bitaxeorg/bitaxeMax/bitaxeMax.kicad_pcb

## KiCad design bitaxeMax.kicad_pcb (2025-03-11)

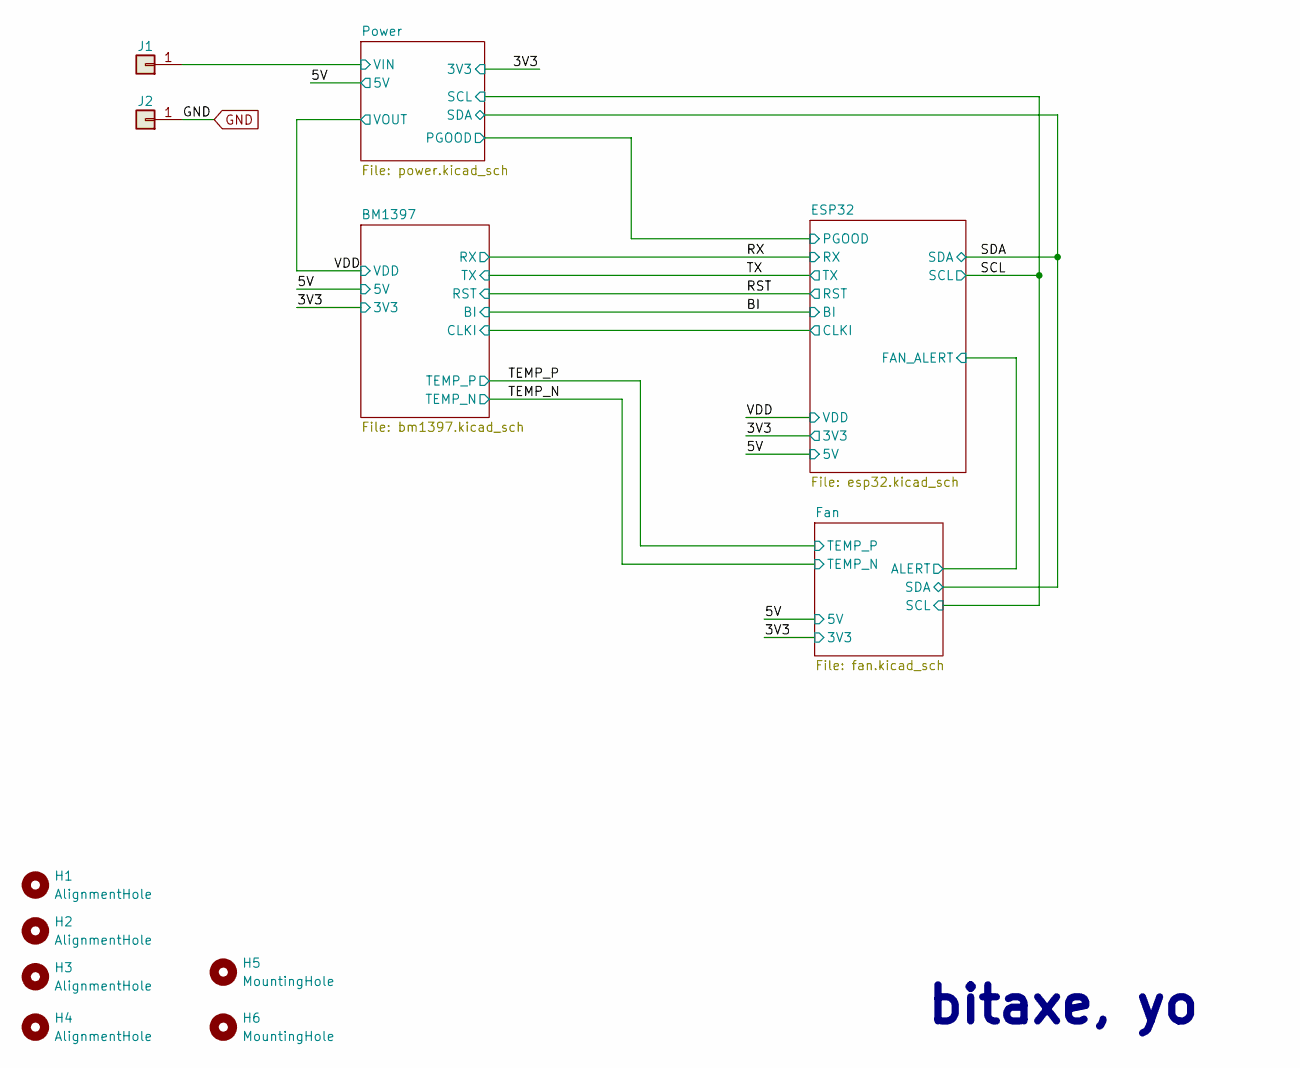
[picture p1: schematic bitaxeMax.kicad_sch, le bitaxeMax]

Parts:
H1, H2, H3, H4: AlignmentHole; MountingHole_2.2mm_M2
H5, H6: MountingHole; MountingHole_3.5mm
J1, J2: Conn_01x01; 63862-1; PARTNO 63862-1

Connections:
/Power/VIN: J1.1; also elsewhere on the board
GND: J2.1; also elsewhere on the board

Notes on the sheet:
bitaxe, yo

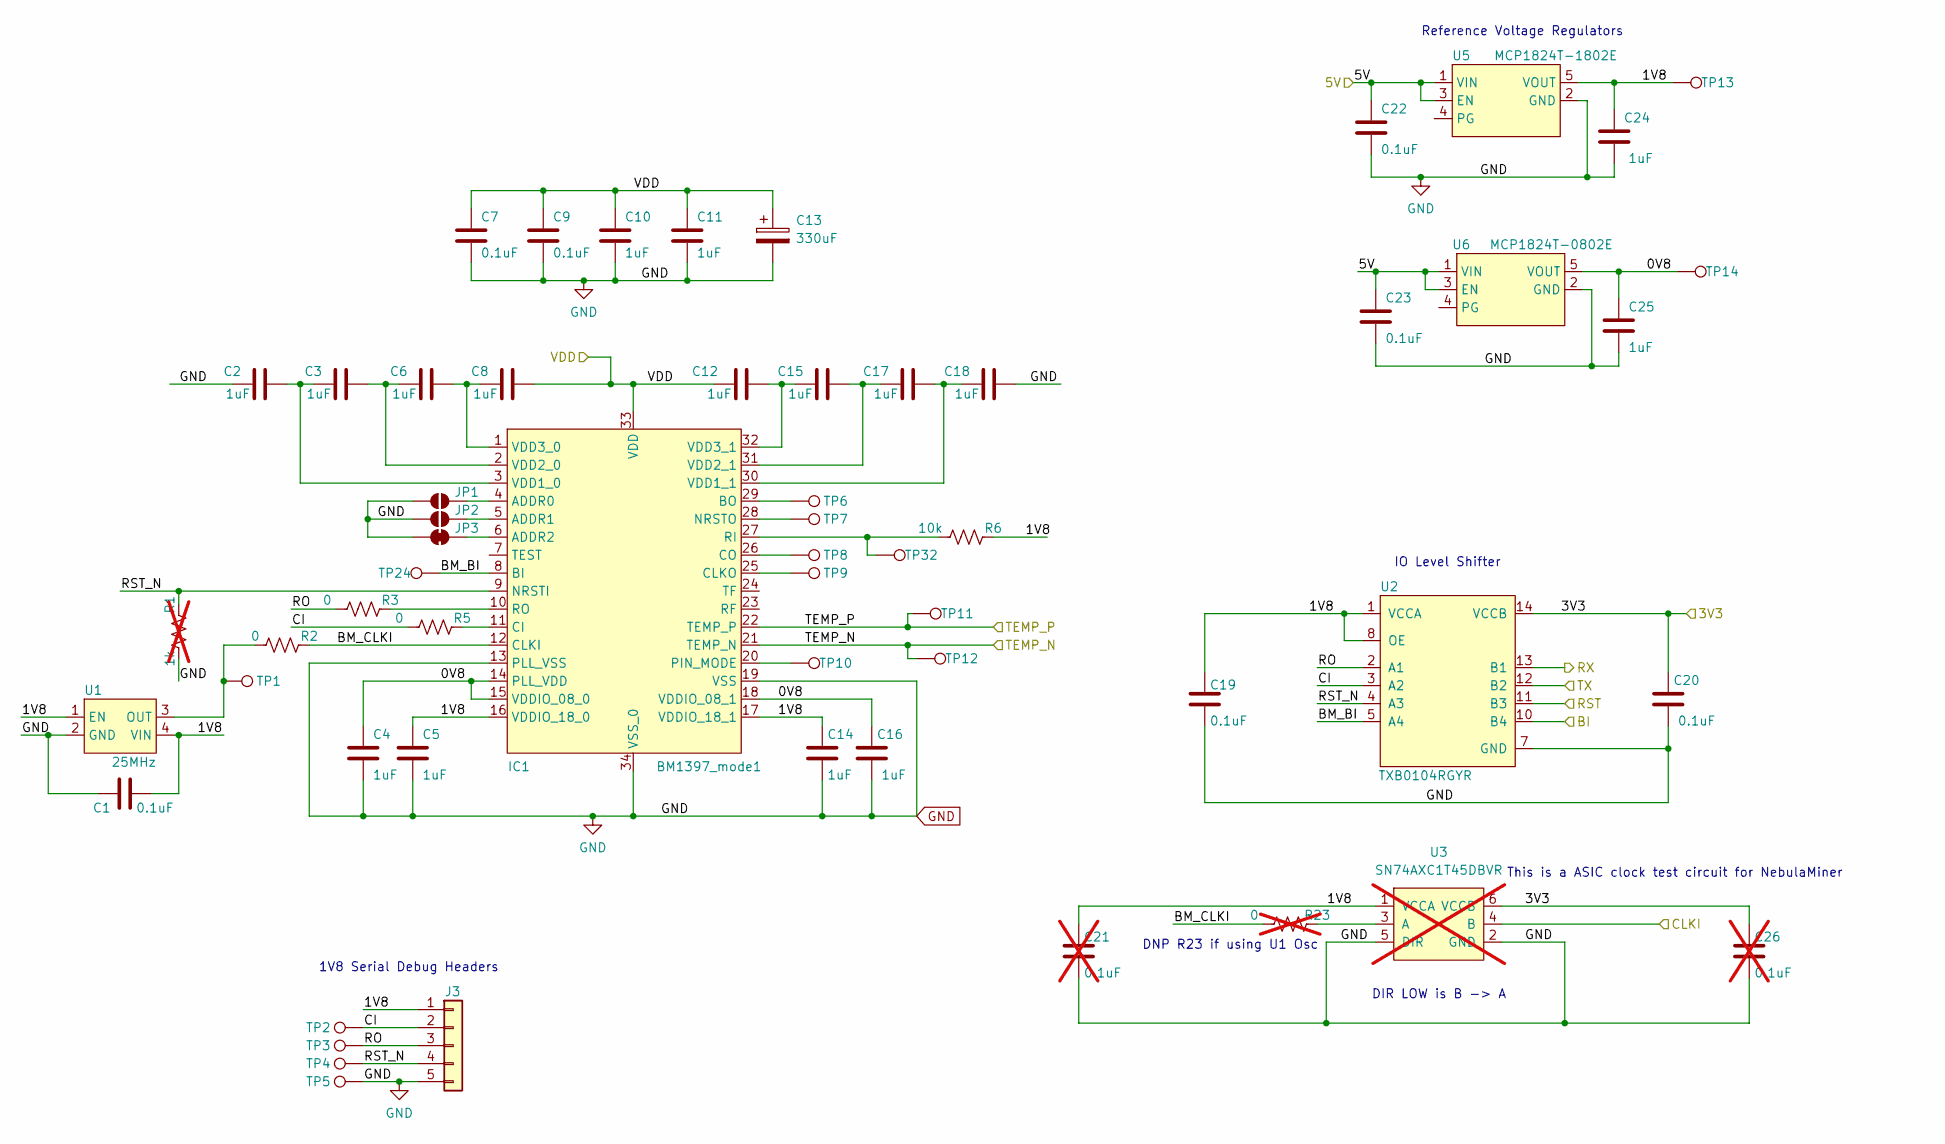
[picture p2: schematic bm1397.kicad_sch]

Parts:
C1, C7, C9, C19, C20, C22, C23: 0.1uF; C_0402_1005Metric; PARTNO 0402X104K100CT
C2, C3, C4, C5, C6, C8, C10, C11, C12, C14, C15, C16, C17, C18, C24, C25: 1uF; C_0402_1005Metric; PARTNO EMK105BJ105MV-F
C13: 330uF; CP_EIA-7343-31_Kemet-D_Pad2.25x2.55mm_HandSolder; PARTNO 293D337X9010E2TE3
C21, C26: 0.1uF; C_0402_1005Metric; PARTNO 0402X104K100CT; not fitted
IC1: BM1397_mode1; BM1397
J3: Conn_01x05; PinHeader_1x05_P2.54mm_Vertical
JP1, JP2: SolderJumper_2_Open; SolderJumper-2_P1.3mm_Open_RoundedPad1.0x1.5mm
JP3: SolderJumper_2_Bridged; SolderJumper-2_P1.3mm_Bridged2Bar_RoundedPad1.0x1.5mm
R1: 1k; R_0402_1005Metric; not fitted
R2, R3, R5: 0; R_0402_1005Metric; PARTNO RMCF0402ZT0R00
R6: 10k; R_0402_1005Metric; PARTNO RC0402JR-0710KL
R23: 0; R_0402_1005Metric; PARTNO RMCF0402ZT0R00; not fitted
TP1, TP2, TP3, TP4, TP5, TP6, TP7, TP8, TP9, TP10, TP11, TP12, TP13, TP14, TP24, TP32: TestPoint; TestPoint_Pad_D1.5mm
U1: 25MHz; O 25,0-JO32-B-1V3-1-T1-LF; PARTNO O 25,0-JO32-B-1V3-1-T1-LF
U2: TXB0104RGYR; TXB0104; PARTNO TXB0104RGYR
U3: SN74AXC1T45DBVR; SN74AXC1T45; PARTNO SN74AXC1T45DBVR; not fitted
U5: MCP1824T-1802E; SOT-23-5; PARTNO MCP1824T-1802E/OT
U6: MCP1824T-0802E; SOT-23-5; PARTNO MCP1824T-0802E/OT

Connections:
/3V3: C20.1, C26.1, U2.14 (VCCB), U3.6 (VCCB); also elsewhere on the board
/5V: C22.1, C23.1, U5.1 (VIN), U5.3 (EN), U6.1 (VIN), U6.3 (EN); also elsewhere on the board
/BI: U2.10 (B4); also elsewhere on the board
/BM1397/0V8: C4.1, C16.1, C25.1, IC1.14 (PLL_VDD), IC1.15 (VDDIO_08_0), IC1.18 (VDDIO_08_1), TP14.1, U6.5 (VOUT)
/BM1397/1V8: C1.2, C5.1, C14.1, C19.1, C21.1, C24.1, IC1.16 (VDDIO_18_0), IC1.17 (VDDIO_18_1), J3.1, R6.2, TP13.1, U1.1 (EN), U1.4 (VIN), U2.1 (VCCA), U2.8 (OE), U3.1 (VCCA), U5.5 (VOUT)
/BM1397/BM_BI: IC1.8 (BI), TP24.1, U2.5 (A4)
/BM1397/BM_CLKI: IC1.12 (CLKI), R2.2, R23.1
/BM1397/CI: J3.2, R5.1, TP2.1, U2.3 (A2)
/BM1397/CLKI: U3.4 (B); also elsewhere on the board
/BM1397/RO: J3.3, R3.1, TP3.1, U2.2 (A1)
/BM1397/RST_N: IC1.9 (NRSTI), J3.4, R1.2, TP4.1, U2.4 (A3)
/RST: U2.11 (B3); also elsewhere on the board
/RX: U2.13 (B1); also elsewhere on the board
/TEMP_N: IC1.21 (TEMP_N), TP12.1; also elsewhere on the board
/TEMP_P: IC1.22 (TEMP_P), TP11.1; also elsewhere on the board
/TX: U2.12 (B2); also elsewhere on the board
/VDD: C7.1, C8.2, C9.1, C10.1, C11.1, C12.1, C13.1, IC1.33 (VDD); also elsewhere on the board
GND: C1.1, C2.1, C4.2, C5.2, C7.2, C9.2, C10.2, C11.2, C13.2, C14.2, C16.2, C18.2, C19.2, C20.2, C21.2, C22.2, C23.2, C24.2, C25.2, C26.2, IC1.13 (PLL_VSS), IC1.19 (VSS), IC1.34 (VSS_0), J3.5, JP1.1 (A), JP2.1 (A), JP3.1 (A), R1.1, TP5.1, U1.2 (GND), U2.7 (GND), U2.15 (GND), U2.16 (GND), U2.17 (GND), U2.18 (GND), U2.19 (GND), U3.2 (GND), U3.5 (DIR), U5.2 (GND), U6.2 (GND); also elsewhere on the board
unnamed: C2.2, C3.1, IC1.3 (VDD1_0)
unnamed: C3.2, C6.1, IC1.2 (VDD2_0)
unnamed: C6.2, C8.1, IC1.1 (VDD3_0)
unnamed: C12.2, C15.1, IC1.32 (VDD3_1)
unnamed: C15.2, C17.1, IC1.31 (VDD2_1)
unnamed: C17.2, C18.1, IC1.30 (VDD1_1)
unnamed: IC1.4 (ADDR0), JP1.2 (B)
unnamed: IC1.5 (ADDR1), JP2.2 (B)
unnamed: IC1.6 (ADDR2), JP3.2 (B)
unnamed: IC1.10 (RO), R3.2
unnamed: IC1.11 (CI), R5.2
unnamed: IC1.20 (PIN_MODE), TP10.1
unnamed: IC1.25 (CLKO), TP9.1
unnamed: IC1.26 (CO), TP8.1
unnamed: IC1.27 (RI), R6.1, TP32.1
unnamed: IC1.28 (NRSTO), TP7.1
unnamed: IC1.29 (BO), TP6.1
unnamed: R2.1, TP1.1, U1.3 (OUT)
unnamed: R23.2, U3.3 (A)

Notes on the sheet:
1V8 Serial Debug Headers
Reference Voltage Regulators
DNP R23 if using U1 Osc
This is a ASIC clock test circuit for NebulaMiner
IO Level Shifter
DIR LOW is B -> A

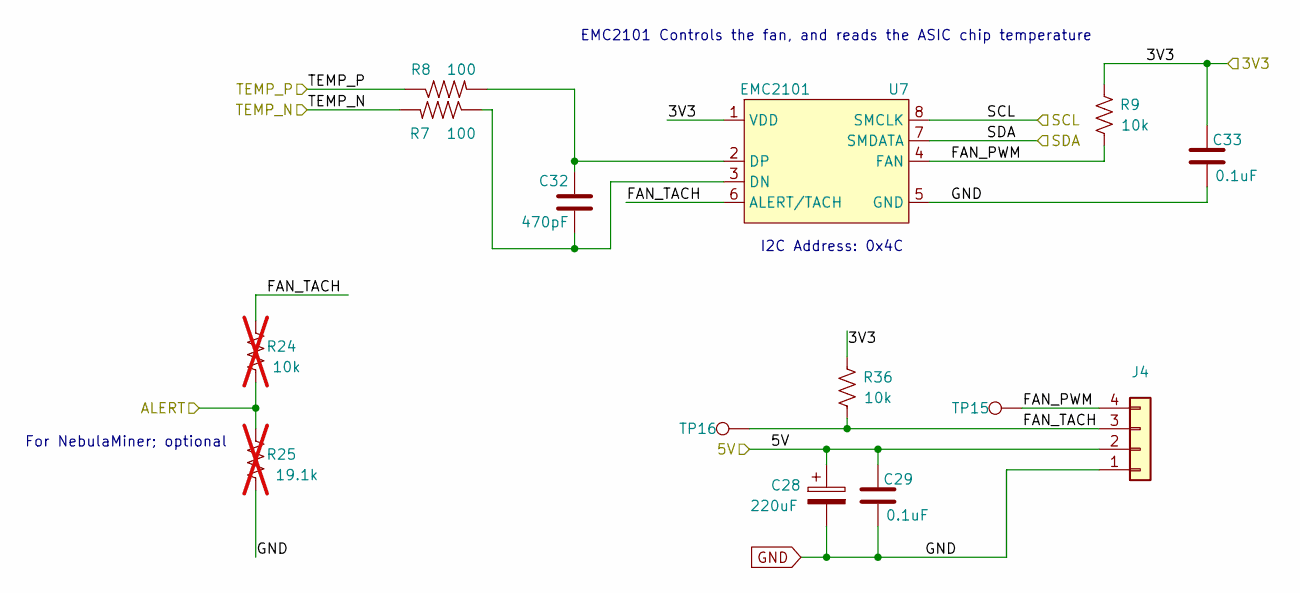
[picture p3: schematic fan.kicad_sch]

Parts:
C28: 220uF; CP_Elec_6.3x7.7; PARTNO 865080345012
C29, C33: 0.1uF; C_0402_1005Metric; PARTNO 0402X104K100CT
C32: 470pF; C_0402_1005Metric; PARTNO CL05B471KB5NNNC
J4: Conn_01x04; 470531000; PARTNO 0470531000
R7, R8: 100; R_0402_1005Metric; PARTNO RMCF0402FT100R
R9, R36: 10k; R_0402_1005Metric; PARTNO RC0402JR-0710KL
R24: 10k; R_0402_1005Metric; PARTNO RC0402JR-0710KL; not fitted
R25: 19.1k; R_0402_1005Metric; PARTNO RC0402FR-0719R1L; not fitted
TP15, TP16: TestPoint; TestPoint_Pad_D1.5mm
U7: EMC2101; TSSOP-8_3x3mm_P0.65mm; PARTNO EMC2101-R-ACZL-TR

Connections:
/3V3: C33.1, R9.2, R36.2, U7.1 (VDD); also elsewhere on the board
/5V: C28.1, C29.1, J4.2; also elsewhere on the board
/ESP32/FAN_ALERT: R24.1, R25.2; also elsewhere on the board
/Fan/FAN_PWM: J4.4, R9.1, TP15.1, U7.4 (FAN)
/Fan/FAN_TACH: J4.3, R24.2, R36.1, TP16.1, U7.6 (ALERT/TACH)
/SCL: U7.8 (SMCLK); also elsewhere on the board
/SDA: U7.7 (SMDATA); also elsewhere on the board
/TEMP_N: R7.2; also elsewhere on the board
/TEMP_P: R8.1; also elsewhere on the board
GND: C28.2, C29.2, C33.2, J4.1, R25.1, U7.5 (GND); also elsewhere on the board
unnamed: C32.1, R8.2, U7.2 (DP)
unnamed: C32.2, R7.1, U7.3 (DN)

Notes on the sheet:
For NebulaMiner; optional
EMC2101 Controls the fan, and reads the ASIC chip temperature
I2C Address: 0x4C

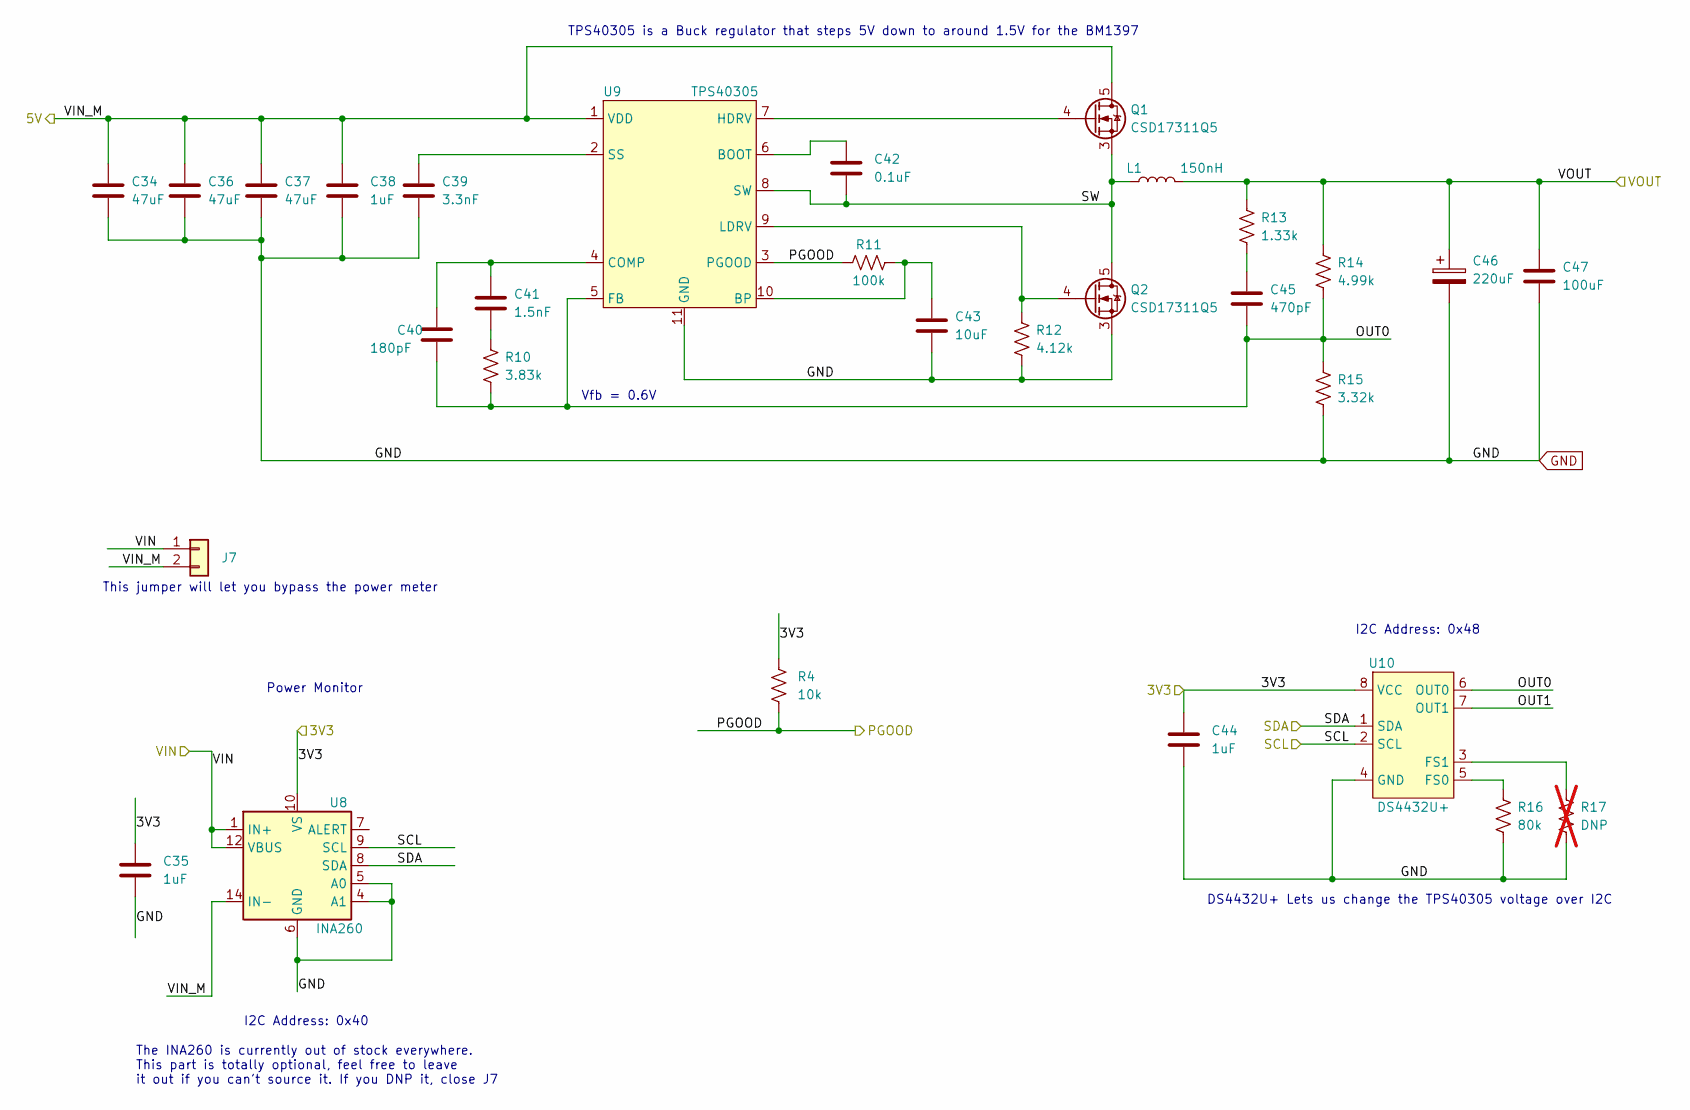
[picture p4: schematic power.kicad_sch]

Parts:
C34, C36, C37: 47uF; C_1210_3225Metric; PARTNO GRM32ER61C476KE15L
C35, C44: 1uF; C_0402_1005Metric; PARTNO EMK105BJ105MV-F
C38: 1uF; C_0805_2012Metric; PARTNO CL21B105KOFNNNG
C39: 3.3nF; C_0402_1005Metric; PARTNO CL05B332KB5NNNC
C40: 180pF; C_0805_2012Metric; PARTNO CC0805JRNPO9BN181
C41: 1.5nF; C_0805_2012Metric; PARTNO CC0805KRX7R9BB152
C42: 0.1uF; C_0402_1005Metric; PARTNO 0402X104K100CT
C43: 10uF; C_0805_2012Metric; PARTNO CL21A106KOQNNNE
C45: 470pF; C_0805_2012Metric; PARTNO 0805B471K500CT
C46: 220uF; CAP_2R5TPE220MAFB; PARTNO 2R5TPE220MAFB
C47: 100uF; C_1206_3216Metric; PARTNO C3216X5R0J107M160AB
J7: Conn_01x02; PinHeader_1x02_P2.54mm_Vertical
L1: 150nH; FP1005R1-R15-R; PARTNO FP1005R1-R15-R
Q1, Q2: CSD17311Q5; PARTNO CSD17311Q5
R4: 10k; R_0402_1005Metric; PARTNO RC0402JR-0710KL
R10: 3.83k; R_0402_1005Metric; PARTNO RC0402FR-073K83L
R11: 100k; R_0402_1005Metric; PARTNO RC0402JR-07100KL
R12: 4.12k; R_0402_1005Metric; PARTNO RMCF0402FT4K12
R13: 1.33k; R_0402_1005Metric; PARTNO RC0402FR-071K33L
R14: 4.99k; R_0402_1005Metric; PARTNO RC0402FR-074K99L
R15: 3.32k; R_0402_1005Metric; PARTNO RC0402FR-073K32L
R16: 80k; R_0402_1005Metric; PARTNO RC0402FR-0780K6L
R17: DNP; R_0402_1005Metric; not fitted
U8: INA260; TSSOP-16_4.4x5mm_P0.65mm; PARTNO INA260AIPWR
U9: TPS40305; PARTNO TPS40305DRCR
U10: DS4432U+; TSSOP-8_3x3mm_P0.65mm; PARTNO DS4432U+

Connections:
/3V3: C35.1, C44.1, R4.1, U8.10 (VS), U10.8 (VCC); also elsewhere on the board
/5V: C34.1, C36.1, C37.1, C38.1, J7.2, Q1.5 (D), U8.14 (IN-), U8.15 (IN-), U8.16 (IN-), U9.1 (VDD); also elsewhere on the board
/Power/OUT0: C40.2, C45.2, R10.2, R14.2, R15.1, U9.5 (FB), U10.6 (OUT0)
/Power/OUT1: U10.7 (OUT1)
/Power/PGOOD: R4.2, R11.1, U9.3 (PGOOD); also elsewhere on the board
/Power/SW: C42.2, L1.1, Q1.1, Q1.2, Q1.3 (S), Q2.5 (D), U9.8 (SW)
/Power/VIN: J7.1, U8.1 (IN+), U8.2 (IN+), U8.3 (IN+), U8.12 (VBUS); also elsewhere on the board
/SCL: U8.9 (SCL), U10.2 (SCL); also elsewhere on the board
/SDA: U8.8 (SDA), U10.1 (SDA); also elsewhere on the board
/VDD: C46.1, C47.1, L1.2, R13.1, R14.1; also elsewhere on the board
GND: C34.2, C35.2, C36.2, C37.2, C38.2, C39.2, C43.2, C44.2, C46.2, C47.2, Q2.1, Q2.2, Q2.3 (S), R12.2, R15.2, R16.2, R17.2, U8.4 (A1), U8.5 (A0), U8.6 (GND), U8.11 (GND), U9.11 (GND), U10.4 (GND); also elsewhere on the board
unnamed: C39.1, U9.2 (SS)
unnamed: C40.1, C41.1, U9.4 (COMP)
unnamed: C41.2, R10.1
unnamed: C42.1, U9.6 (BOOT)
unnamed: C43.1, R11.2, U9.10 (BP)
unnamed: C45.1, R13.2
unnamed: Q1.4 (G), U9.7 (HDRV)
unnamed: Q2.4 (G), R12.1, U9.9 (LDRV)
unnamed: R16.1, U10.5 (FS0)
unnamed: R17.1, U10.3 (FS1)

Notes on the sheet:
DS4432U+ Lets us change the TPS40305 voltage over I2C
I2C Address: 0x48
The INA260 is currently out of stock everywhere. This part is totally optional, feel free to leave it out if you can't source it. If you DNP it, close J7
Power Monitor
TPS40305 is a Buck regulator that steps 5V down to around 1.5V for the BM1397
I2C Address: 0x40
Vfb = 0.6V
This jumper will let you bypass the power meter

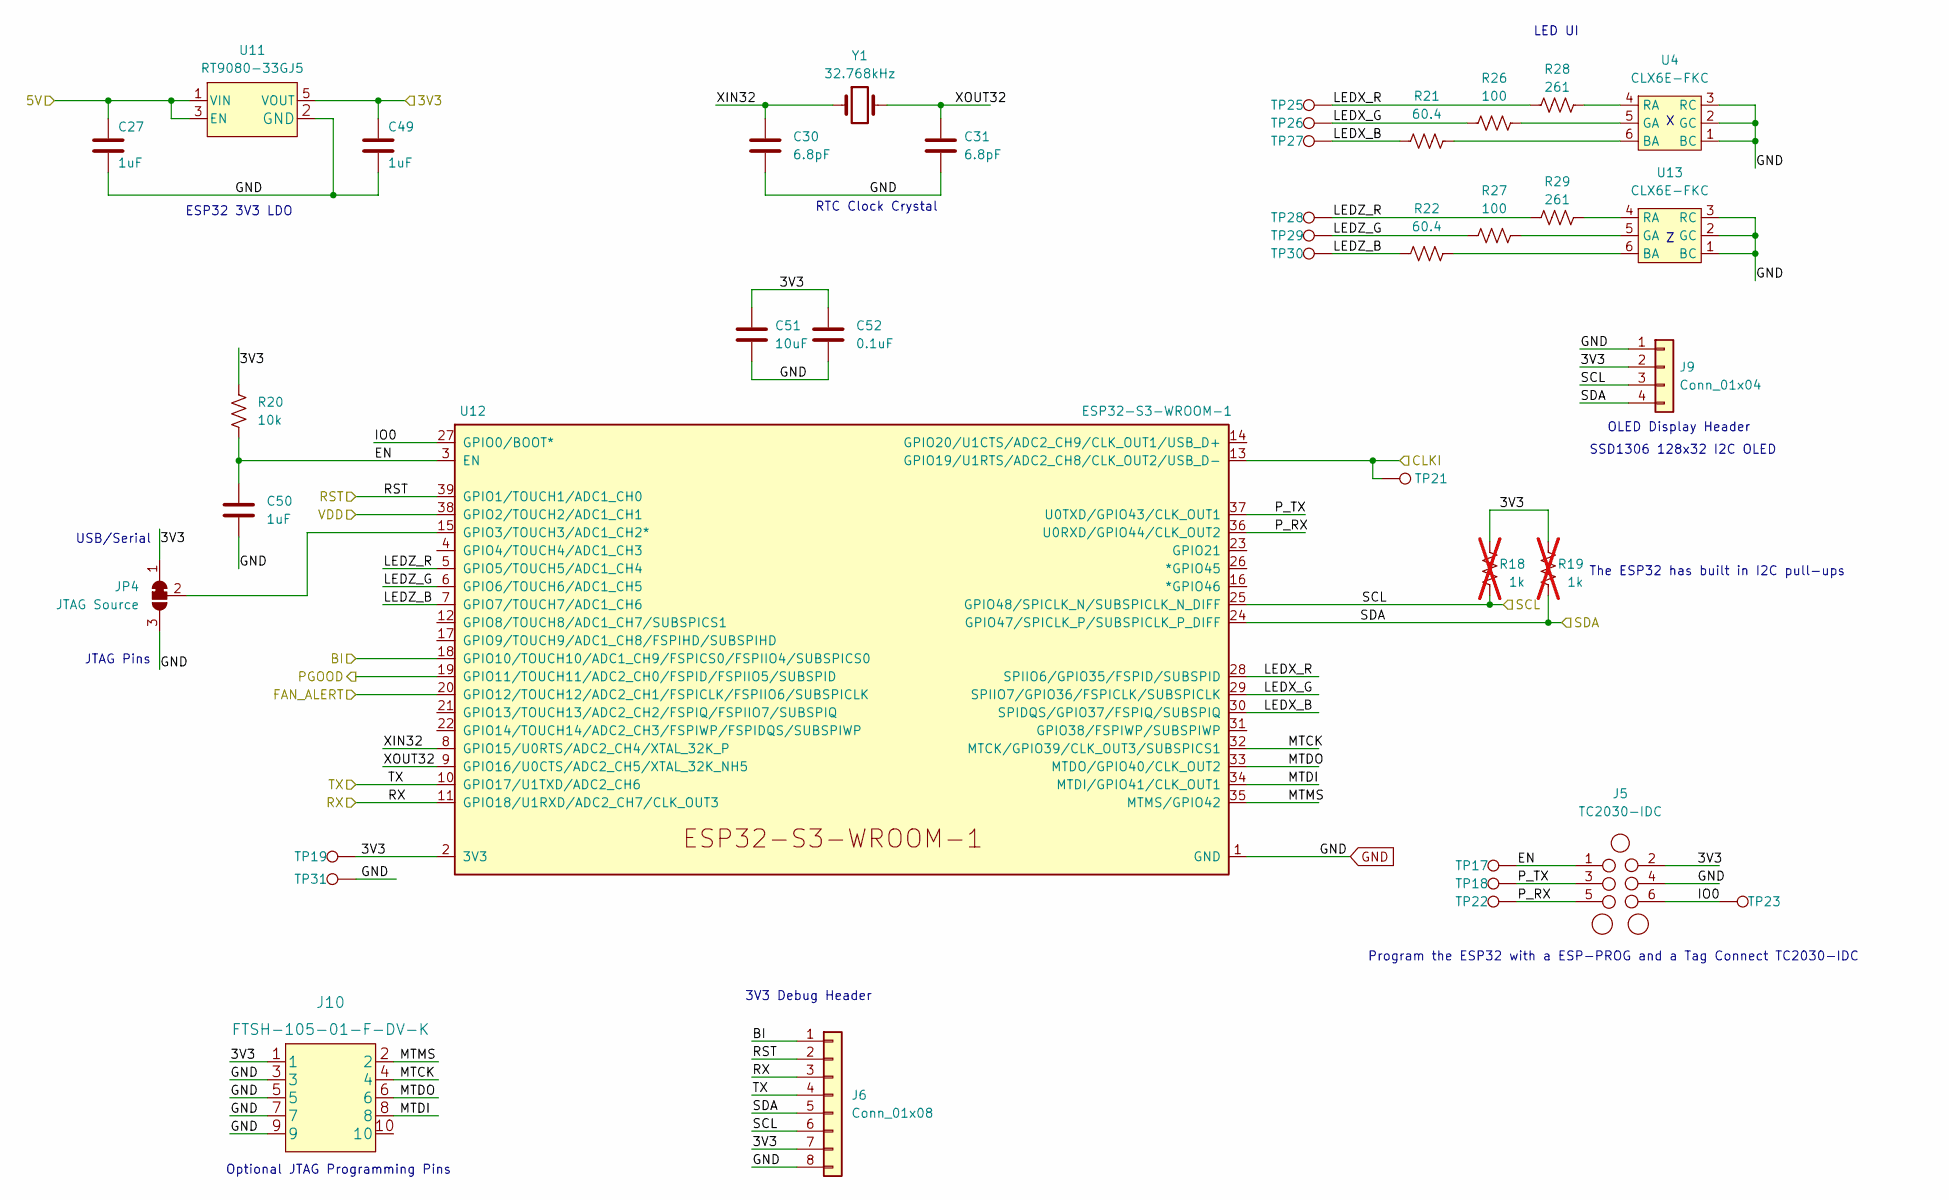
[picture p5: schematic esp32.kicad_sch]

Parts:
C27, C49, C50: 1uF; C_0402_1005Metric; PARTNO EMK105BJ105MV-F
C30, C31: 6.8pF; C_0402_1005Metric; PARTNO C0402C689C5GAC7867
C51: 10uF; C_0805_2012Metric; PARTNO CL21A106KOQNNNE
C52: 0.1uF; C_0402_1005Metric; PARTNO 0402X104K100CT
J5: TC2030-IDC; Tag-Connect_TC2030-IDC-NL_2x03_P1.27mm_Vertical
J6: Conn_01x08; PinHeader_1x08_P2.54mm_Vertical
J9: Conn_01x04; PinHeader_1x04_P2.54mm_Vertical
J10: FTSH-105-01-F-DV-K; PARTNO FTSH-105-01-F-DV-K
JP4: JTAG Source; SolderJumper-3_P1.3mm_Bridged2Bar12_Pad1.0x1.5mm
R18, R19: 1k; R_0402_1005Metric; not fitted
R20: 10k; R_0402_1005Metric; PARTNO RC0402JR-0710KL
R21, R22: 60.4; R_0402_1005Metric; PARTNO RC0402FR-0760R4L
R26, R27: 100; R_0402_1005Metric; PARTNO RMCF0402FT100R
R28, R29: 261; R_0402_1005Metric; PARTNO RC0402FR-07261RL
TP17, TP18, TP19, TP21, TP22, TP23, TP25, TP26, TP27, TP28, TP29, TP30, TP31: TestPoint; TestPoint_Pad_D1.5mm
U4, U13: CLX6E-FKC; CLX6E-FKC-CH1M1D1BB7C3D3; PARTNO CLX6E-FKC-CH1M1D1BB7C3D3
U11: RT9080-33GJ5; PARTNO RT9080-33GJ5
U12: ESP32-S3-WROOM-1; PARTNO ESP32-S3-WROOM-1-N16R8
Y1: 32.768kHz; SC32S-7PF20PPM; PARTNO SC32S-7PF20PPM

Connections:
/3V3: C49.1, C51.1, C52.1, J5.2, J6.7, J9.2, J10.1, JP4.1 (A), R18.2, R19.2, R20.1, TP19.1, U11.5 (VOUT), U12.2 (3V3); also elsewhere on the board
/5V: C27.1, U11.1 (VIN), U11.3 (EN); also elsewhere on the board
/BI: J6.1, U12.18 (GPIO10/TOUCH10/ADC1_CH9/FSPICS0/FSPIIO4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); also elsewhere on the board
/BM1397/CLKI: TP21.1, U12.13 (GPIO19/U1RTS/ADC2_CH8/CLK_OUT2/USB_D-); also elsewhere on the board
/ESP32/EN: C50.1, J5.1, R20.2, TP17.1, U12.3 (EN)
/ESP32/FAN_ALERT: U12.20 (GPIO12/TOUCH12/ADC2_CH1/FSPICLK/FSPIIO6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); also elsewhere on the board
/ESP32/IO0: J5.6, TP23.1, U12.27 (GPIO0/BOOT*)
/ESP32/LEDX_B: R21.1, TP27.1, U12.30 (SPIDQS/GPIO37/FSPIQ/SUBSPIQ)
/ESP32/LEDX_G: R26.1, TP26.1, U12.29 (SPIIO7/GPIO36/FSPICLK/SUBSPICLK)
/ESP32/LEDX_R: R28.1, TP25.1, U12.28 (SPIIO6/GPIO35/FSPID/SUBSPID)
/ESP32/LEDZ_B: R22.1, TP30.1, U12.7 (GPIO7/TOUCH7/ADC1_CH6)
/ESP32/LEDZ_G: R27.1, TP29.1, U12.6 (GPIO6/TOUCH6/ADC1_CH5)
/ESP32/LEDZ_R: R29.1, TP28.1, U12.5 (GPIO5/TOUCH5/ADC1_CH4)
/ESP32/MTCK: J10.4, U12.32 (MTCK/GPIO39/CLK_OUT3/SUBSPICS1)
/ESP32/MTDI: J10.8, U12.34 (MTDI/GPIO41/CLK_OUT1)
/ESP32/MTDO: J10.6, U12.33 (MTDO/GPIO40/CLK_OUT2)
/ESP32/MTMS: J10.2, U12.35 (MTMS/GPIO42)
/ESP32/P_RX: J5.5, TP22.1, U12.36 (U0RXD/GPIO44/CLK_OUT2)
/ESP32/P_TX: J5.3, TP18.1, U12.37 (U0TXD/GPIO43/CLK_OUT1)
/ESP32/XIN32: C30.1, U12.8 (GPIO15/U0RTS/ADC2_CH4/XTAL_32K_P), Y1.1
/ESP32/XOUT32: C31.1, U12.9 (GPIO16/U0CTS/ADC2_CH5/XTAL_32K_NH5), Y1.2
/Power/PGOOD: U12.19 (GPIO11/TOUCH11/ADC2_CH0/FSPID/FSPIIO5/S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); also elsewhere on the board
/RST: J6.2, U12.39 (GPIO1/TOUCH1/ADC1_CH0); also elsewhere on the board
/RX: J6.3, U12.11 (GPIO18/U1RXD/ADC2_CH7/CLK_OUT3); also elsewhere on the board
/SCL: J6.6, J9.3, R18.1, U12.25 (GPIO48/SPICLK_N/SUBSPICLK_N_DIFF); also elsewhere on the board
/SDA: J6.5, J9.4, R19.1, U12.24 (GPIO47/SPICLK_P/SUBSPICLK_P_DIFF); also elsewhere on the board
/TX: J6.4, U12.10 (GPIO17/U1TXD/ADC2_CH6); also elsewhere on the board
/VDD: U12.38 (GPIO2/TOUCH2/ADC1_CH1); also elsewhere on the board
GND: C27.2, C30.2, C31.2, C49.2, C50.2, C51.2, C52.2, J5.4, J6.8, J9.1, J10.3, J10.5, J10.7, J10.9, JP4.3 (B), TP31.1, U4.1 (BC), U4.2 (GC), U4.3 (RC), U11.2 (GND), U12.1 (GND), U12.40 (GND), U12.41 (GND), U13.1 (BC), U13.2 (GC), U13.3 (RC); also elsewhere on the board
unnamed: R21.2, U4.6 (BA)
unnamed: R22.2, U13.6 (BA)
unnamed: R26.2, U4.5 (GA)
unnamed: R27.2, U13.5 (GA)
unnamed: R28.2, U4.4 (RA)
unnamed: R29.2, U13.4 (RA)
unnamed: JP4.2 (C), U12.15 (GPIO3/TOUCH3/ADC1_CH2*)

Notes on the sheet:
RTC Clock Crystal
JTAG Pins
ESP32 3V3 LDO
Program the ESP32 with a ESP-PROG and a Tag Connect TC2030-IDC
The ESP32 has built in I2C pull-ups
3V3 Debug Header
Optional JTAG Programming Pins
SSD1306 128x32 I2C OLED
LED UI
OLED Display Header
USB/Serial

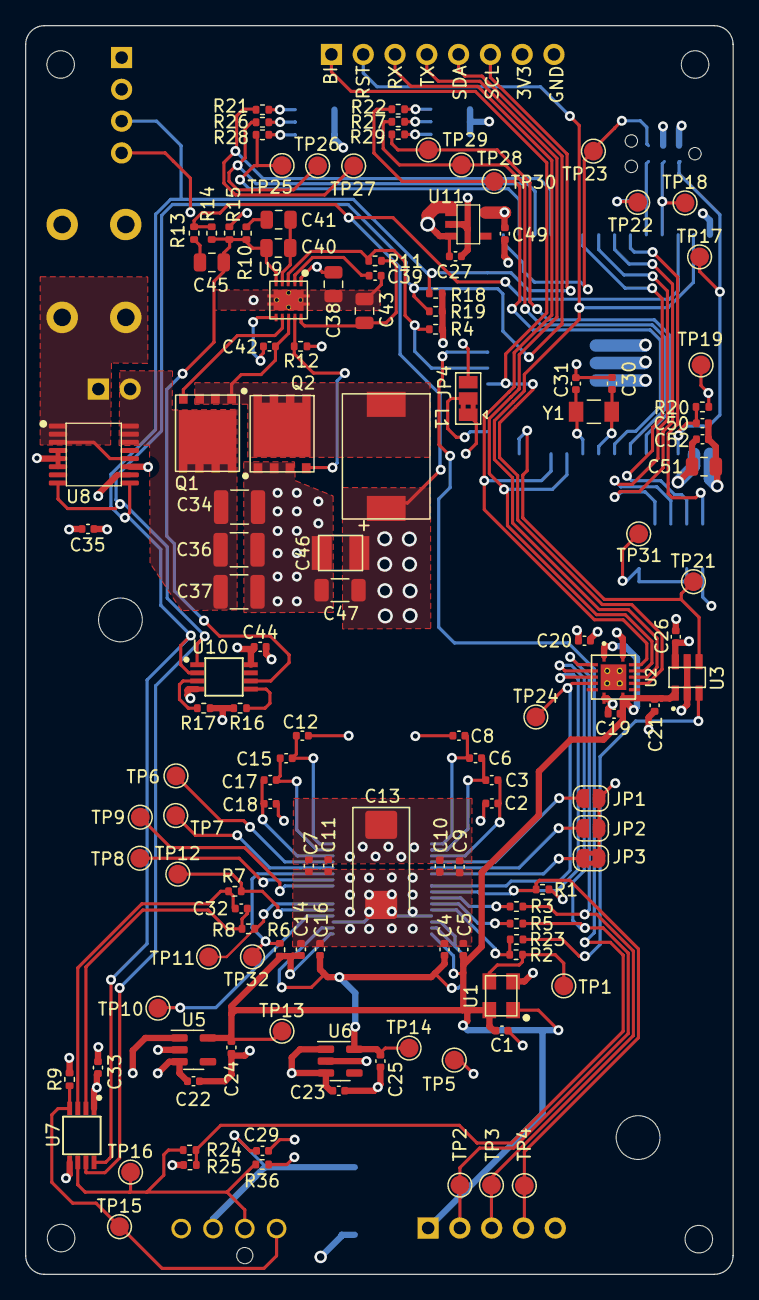
[picture p6: board bitaxeMax.kicad_pcb from above]

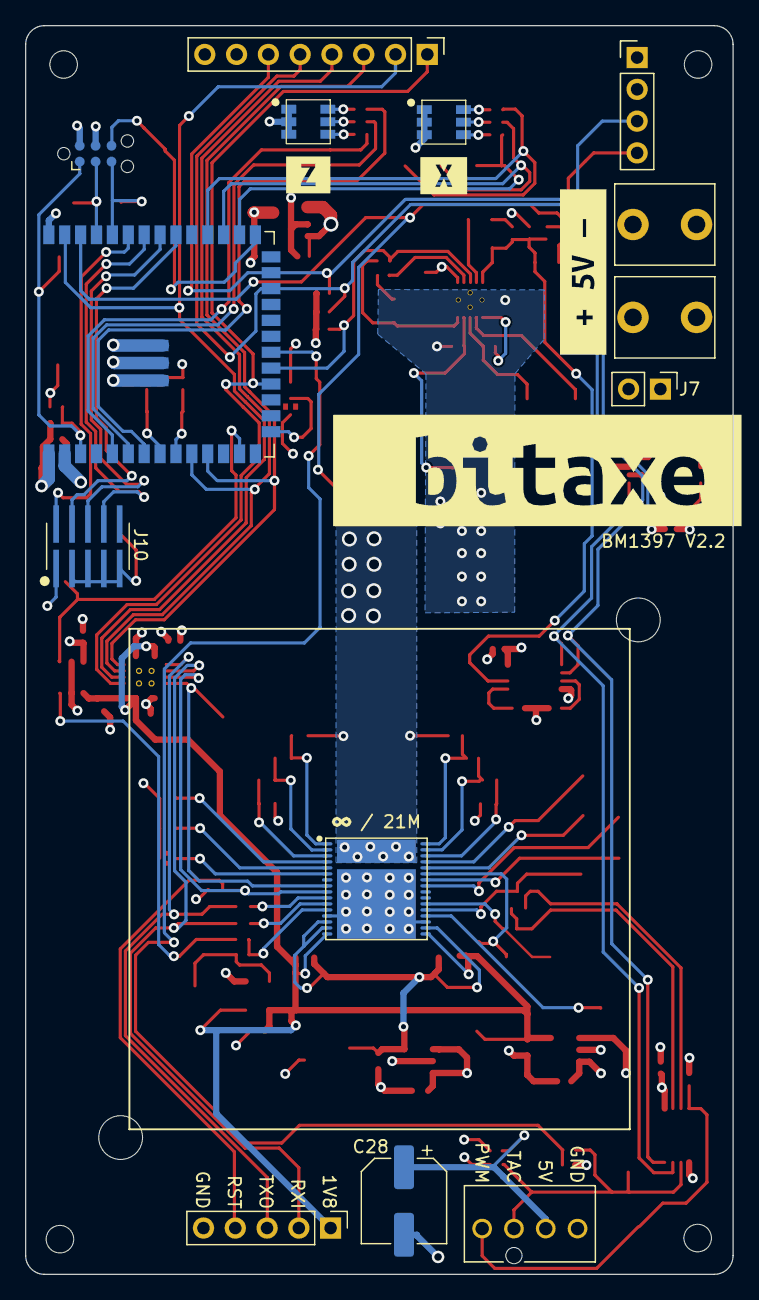
[picture p7: board bitaxeMax.kicad_pcb from below]

Board: 4 copper layers, 56.5 x 99.8 mm, 153 parts (18 on the bottom side), 81 nets.

Other parts of the board:
kibuzzard-63D74789: G***; kibuzzard-63D74789
kibuzzard-6387EEBE: G***; kibuzzard-6387EEBE
kibuzzard-6387EECB: G***; kibuzzard-6387EECB
kibuzzard-6392B1E5: G***; kibuzzard-6392B1E5
